usagi-avionica/usagi-core/usagi-core.kicad_pcb

## KiCad design usagi-core.kicad_pcb (2026-11-13)

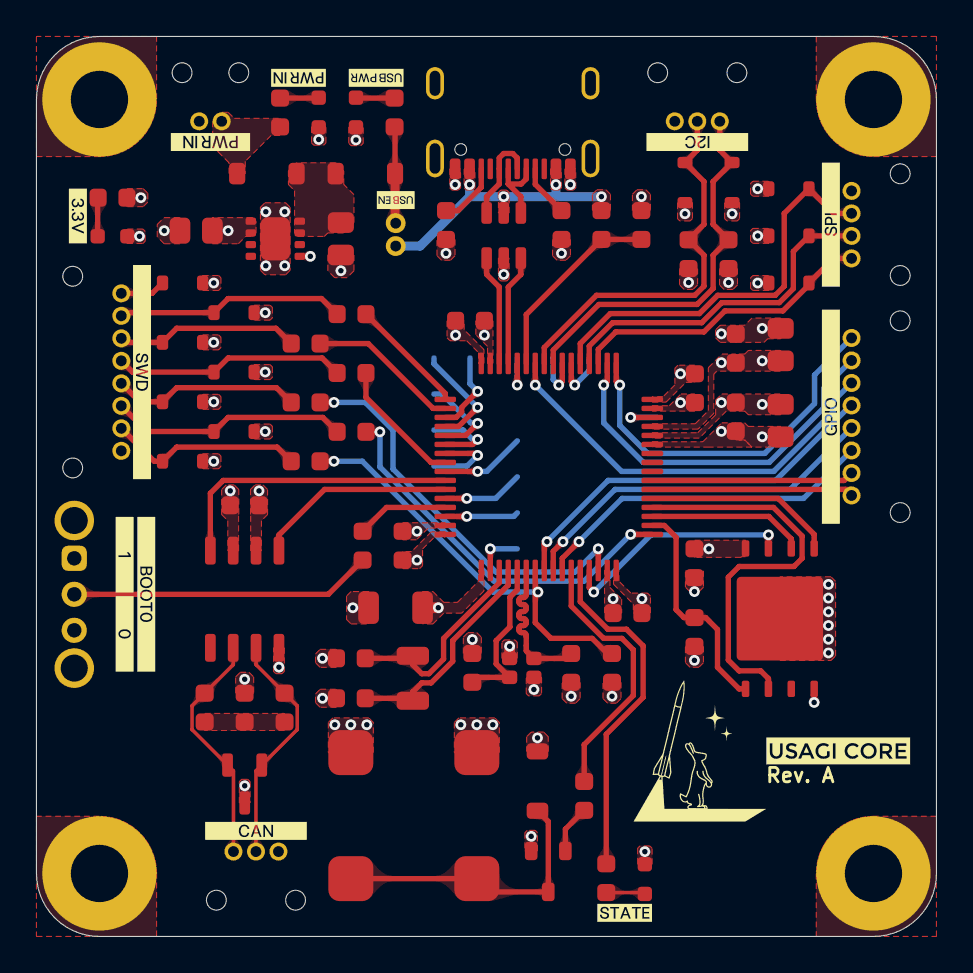
[picture p1: board usagi-core.kicad_pcb from above]

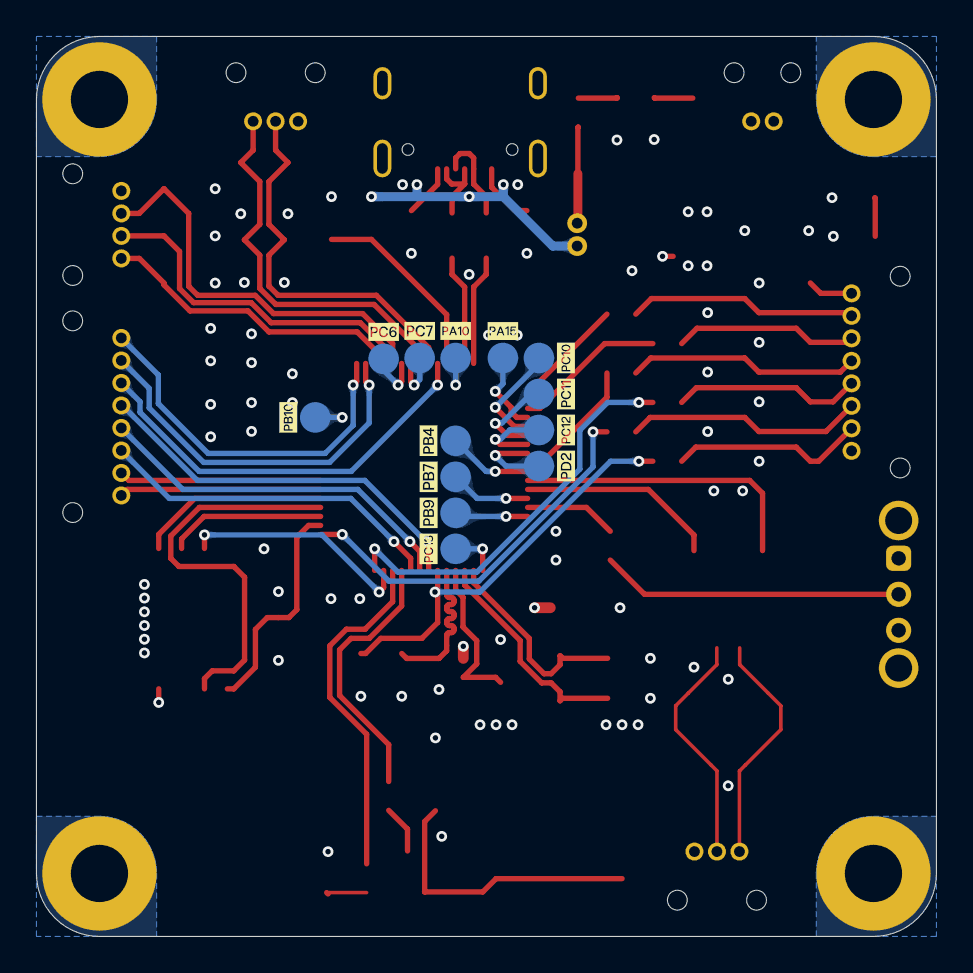
[picture p2: board usagi-core.kicad_pcb from below]

Board: 4 copper layers, 50.0 x 50.0 mm, 123 parts (26 on the bottom side), 75 nets.

Parts:
BZ1: CMT-8540S-SMT-TR
C1, C2, C3, C4, C8, C10, C15, C17: 100nF; C_0603_Density_Nominal
C5: 4.7μF; C_1206_Density_Nominal
C6: 10nF; C_0603_Density_Nominal
C7, C9, C18: 1μF; C_0805_Density_Nominal
C11, C12: 6.8pF; C_0603_Density_Nominal
C13, C14: 5.1pF; C_0603_Density_Nominal
C16: 4.7nF; C_0603_Density_Nominal
C19: 10μF; C_0805_Density_Nominal
D1, D15, D18, D19: Green; SML-D12P8WT86C
D2, D3, D4, D5, D6, D7, D8, D9, D10, D11, D12, D13: SZESD7351HT1G
D14, D16, D17: STPS140ZY
J1: USB4105-GF-A-120
J2, J7: 2200980871
J3, J4: 2200980371
J5: 2200980471
J6: 2200980271
J8, J9, J10, J11, J12, J13, J14, J15, J16, J17, J18, J19, J20: SolderPad
J21: M50-3530242
MH1, MH2, MH3, MH4: M3
Q1: SMMBT2222ALT1G
R1, R2: 1.8kΩ; R_0603_Density_Nominal
R3, R8: 10kΩ; R_0603_Density_Nominal
R4, R5: 5.1kΩ; R_0603_Density_Nominal
R6: 82kΩ; R_0603_Density_Nominal
R7: 33kΩ; R_0603_Density_Nominal
R9, R10: 60.4Ω; R_0603_Density_Nominal
R11, R21: 100Ω; R_0603_Density_Nominal
R12, R13, R14, R15, R16, R17: 49.9Ω; R_0603_Density_Nominal
R18, R19, R20: 220Ω; R_0603_Density_Nominal
SW1: OS102011MA1QN1
U1: STM32G474RET3
U2: USBLC6-2SC6
U3: S25FL256LAGNFM010
U4: SN65HVD231QDRG4Q1
U5: ESD2CAN24DBZRQ1
U6: NCV8187AMLE330TCG
Y1: 24MHz; CS10820-24M
Y2: 32.768kHz; MU00525-32.768K
kibuzzard-6AF2C97C: G***; kibuzzard-6AF2C97C
kibuzzard-6AF2CA52: G***; kibuzzard-6AF2CA52
kibuzzard-6AF2CCF0: G***; kibuzzard-6AF2CCF0
kibuzzard-6AF3A4A3: G***; kibuzzard-6AF3A4A3
kibuzzard-6AF3A46B: G***; kibuzzard-6AF3A46B
kibuzzard-6AF3A47A: G***; kibuzzard-6AF3A47A
kibuzzard-6AF3A482: G***; kibuzzard-6AF3A482
kibuzzard-6AF3A495: G***; kibuzzard-6AF3A495
kibuzzard-6AF5A14A: G***; kibuzzard-6AF5A14A
kibuzzard-6AF5D7C2: G***; kibuzzard-6AF5D7C2
kibuzzard-6AF578D1: G***; kibuzzard-6AF578D1
kibuzzard-6AF578DA: G***; kibuzzard-6AF578DA
kibuzzard-6AF578E0: G***; kibuzzard-6AF578E0
kibuzzard-6AF578EA: G***; kibuzzard-6AF578EA
kibuzzard-6AF1947B: G***; kibuzzard-6AF1947B
kibuzzard-6AF1962F: G***; kibuzzard-6AF1962F
kibuzzard-6AF4418B: G***; kibuzzard-6AF4418B
kibuzzard-6AF5783D: G***; kibuzzard-6AF5783D
kibuzzard-6AF5791D: G***; kibuzzard-6AF5791D
kibuzzard-6AF5792A: G***; kibuzzard-6AF5792A
kibuzzard-6AF5796A: G***; kibuzzard-6AF5796A
kibuzzard-6AF19634: G***; kibuzzard-6AF19634
kibuzzard-6AF44698: G***; kibuzzard-6AF44698
kibuzzard-6AF57785: G***; kibuzzard-6AF57785
kibuzzard-6AF57819: G***; kibuzzard-6AF57819
kibuzzard-6AF57844: G***; kibuzzard-6AF57844
kibuzzard-6AF57915: G***; kibuzzard-6AF57915
kibuzzard-6AF57924: G***; kibuzzard-6AF57924

Connections:
+3.3V: BZ1.1 (+), C1.1, C2.1, C3.1, C4.1, C5.1, C6.1, C7.1, C8.1, C9.1, C15.1, C17.1, C19.1, D2.1, D14.1, J2.1, R1.1, R2.1, R8.1, R21.1, SW1.1, U1.1 (VBAT), U1.16 (VDD), U1.28 (VREF+), U1.29 (VDDA), U1.32 (VDD), U1.48 (VDD), U1.64 (VDD), U3.8 (VCC), U4.3 (VCC), U6.1 (OUT), U6.2 (SNS)
/CAN_N: J3.1, R10.2, U4.6 (CANL), U5.2 (I/O2)
/CAN_P: J3.2, R9.1, U4.7 (CANH), U5.1 (I/O1)
/MCU_BOOT0: R3.1, U1.61 (BOOT0)
/MCU_HSE_IN: C11.1, U1.5 (OSC_IN), Y1.1
/MCU_HSE_OUT: C12.1, U1.6 (OSC_OUT), Y1.3
/MCU_LED: R11.1, U1.12 (PA0)
/MCU_LSE_IN: C13.1, U1.3 (OSC32_IN), Y2.1
/MCU_LSE_OUT: C14.1, U1.4 (OSC32_OUT), Y2.2
/USB_CONN_CC1: J1.A5 (CC1), R5.1
/USB_CONN_CC2: J1.B5 (CC2), R4.1
/USB_CONN_D+: J1.A6 (DP1), J1.B6 (DP2), U2.6 (I/O1)
/USB_CONN_D-: J1.A7 (DN1), J1.B7 (DN2), U2.4 (I/O2)
GND: C1.2, C2.2, C3.2, C4.2, C5.2, C6.2, C7.2, C8.2, C9.2, C10.2, C11.2, C12.2, C13.2, C14.2, C15.2, C16.2, C17.2, C18.2, C19.2, D1.1, D2.2, D3.2, D4.2, D5.2, D6.2, D7.2, D8.2, D9.2, D10.2, D11.2, D12.2, D13.2, D15.1, D18.1, D19.1, J1.A1 (GND), J1.A12 (GND), J1.B1 (GND), J1.B12 (GND), J1.SH, J2.8, J3.3, J4.3, J5.4, J6.2, Q1.2 (E), R4.2, R5.2, R7.2, SW1.3, U1.15 (VSS), U1.27 (VSSA), U1.31 (VSS), U1.47 (VSS), U1.63 (VSS), U2.2 (GND), U3.4 (VSS), U3.9 (EP), U4.2 (GND), U4.8 (RS), U5.3 (GND), U6.5 (GND), U6.9 (GND), Y1.2 (GND), Y1.4 (GND)
MCU_BUZZER: R18.1, U1.11 (PC3)
MCU_CAN2_RX: U1.58 (FDCAN2_RX), U4.4 (R)
MCU_CAN2_TX: U1.59 (FDCAN2_TX), U4.1 (D)
MCU_I2C3_SCL: D10.1, J4.1, R1.2, U1.40 (I2C3_SCL)
MCU_I2C3_SDA: D9.1, J4.2, R2.2, U1.41 (I2C3_SDA)
MCU_MEM_CS: R8.2, U1.18 (PA4), U3.1 (CS)
MCU_MEM_NRST: U1.13 (PA1), U3.7 (~RESET)
MCU_NRST: C10.1, R15.1, U1.7 (NRST)
MCU_SPI1_MISO: U1.20 (SPI1_MISO), U3.2 (SO)
MCU_SPI1_MOSI: U1.21 (SPI1_MOSI), U3.5 (SI)
MCU_SPI1_SCK: U1.19 (SPI1_SCK), U3.6 (SCK)
MCU_SPI2_MISO: D12.1, J5.2, U1.36 (SPI2_MISO)
MCU_SPI2_MOSI: D11.1, J5.3, U1.37 (SPI2_MOSI)
MCU_SPI2_SCK: D13.1, J5.1, U1.35 (SPI2_SCK)
MCU_SWCLK: R13.1, U1.50 (SWCLK-JTCK)
MCU_SWDIO: R12.1, U1.49 (SWDIO-JTMS)
MCU_SWO: R14.1, U1.56 (JTDO-TRACESWO)
MCU_USART2_RX: R16.1, U1.17 (USART2_RX)
MCU_USART2_TX: R17.1, U1.14 (USART2_TX)
MCU_USB_D+: U1.46 (USB_DP), U2.1 (I/O1)
MCU_USB_D-: U1.45 (USB_DM), U2.3 (I/O2)
MCU_USB_VUSB: R6.2, R7.1, U1.43 (PA9)
unnamed: BZ1.2 (-), D14.2, Q1.3 (C)
unnamed: C16.1, R9.2, R10.1
unnamed: D1.2, R11.2
unnamed: D3.1, J2.2, R12.2
unnamed: D4.1, J2.3, R13.2
unnamed: D5.1, J2.4, R14.2
unnamed: D6.1, J2.5, R17.2
unnamed: D7.1, J2.6, R16.2
unnamed: D8.1, J2.7, R15.2
unnamed: D15.2, R19.2
unnamed: D16.2, J6.1, R20.1
unnamed: D17.2, J21.2, R19.1
unnamed: D18.2, R20.2
unnamed: D19.2, R21.2
unnamed: Q1.1 (B), R18.2
unnamed: R3.2, SW1.2
unnamed: C18.1, D16.1, D17.1, U6.7 (EN), U6.8 (IN)
PA8: J7.6, U1.42 (PA8)
PA10: J8.1 (1_1), U1.44 (PA10)
PA15: J20.1 (1_1), U1.51 (PA15)
PB4: J15.1 (1_1), U1.57 (PB4)
PB7: J14.1 (1_1), U1.60 (PB7)
PB9: J13.1 (1_1), U1.62 (PB9)
PB10: J11.1 (1_1), U1.30 (PB10)
PB11: J7.8, U1.33 (PB11)
PB12: J7.7, U1.34 (PB12)
PC0: J7.5, U1.8 (PC0)
PC1: J7.4, U1.9 (PC1)
PC2: J7.3, U1.10 (PC2)
PC4: J7.1, U1.22 (PC4)
PC5: J7.2, U1.23 (PC5)
PC6: J10.1 (1_1), U1.38 (PC6)
PC7: J9.1 (1_1), U1.39 (PC7)
PC10: J19.1 (1_1), U1.52 (PC10)
PC11: J18.1 (1_1), U1.53 (PC11)
PC12: J17.1 (1_1), U1.54 (PC12)
PC13: J12.1 (1_1), U1.2 (PC13)
PD2: J16.1 (1_1), U1.55 (PD2)
VUSB: J1.A4 (VBUS), J1.A9 (VBUS), J1.B4 (VBUS), J1.B9 (VBUS), J21.1, R6.1, U2.5 (VBUS)
