usagi-avionica/usagi-core/usagi-core.ioc

Mcu.UserName=STM32G474RETx
PA0.GPIO_Label=MCU_LED
PA0.Signal=GPIO_Output
PA1.GPIO_Label=MCU_MEM_NRST
PA1.Signal=GPIO_Output
PA11.Signal=USB_DM
PA12.Signal=USB_DP
PA13.Signal=SYS_JTMS-SWDIO
PA14.Signal=SYS_JTCK-SWCLK
PA2.Signal=USART2_TX
PA3.Signal=USART2_RX
PA4.GPIO_Label=MCU_MEM_CS
PA4.Signal=GPIO_Output
PA5.Signal=SPI1_SCK
PA6.Signal=SPI1_MISO
PA7.Signal=SPI1_MOSI
PA9.GPIO_Label=USB_VBUS
PA9.Signal=GPIO_Input
PB13.Signal=SPI2_SCK
PB14.Signal=SPI2_MISO
PB15.Signal=SPI2_MOSI
PB3.Signal=SYS_JTDO-SWO
PB5.Signal=FDCAN2_RX
PB6.Signal=FDCAN2_TX
PC14-OSC32_IN.Signal=RCC_OSC32_IN
PC15-OSC32_OUT.Signal=RCC_OSC32_OUT
PC3.Signal=S_TIM1_CH4
PC8.Signal=I2C3_SCL
PC9.Signal=I2C3_SDA
PF0-OSC_IN.Signal=RCC_OSC_IN
PF1-OSC_OUT.Signal=RCC_OSC_OUT
