usagi-avionica/usagi-core/(commit log)

2026-11-12 Initial commit.
    [usagi-core.kicad_pcb, usagi-core.kicad_sch]
2026-11-12 Add missing project text variables.
    [usagi-core.kicad_pcb, usagi-core.kicad_sch]
2026-11-12 Enable font embedding.
    [usagi-core.kicad_pcb, usagi-core.kicad_sch]
2026-11-12 Pin workflow to Ubuntu 24.04
2026-11-12 Change power "pin not driven" severity from error to warning.
2026-11-12 Fix PCB colors in preview images, change release structure to be flatter.
2026-11-12 Fix 3.3V plane pour priority.
    [usagi-core.kicad_pcb]
2026-11-13 Add dimensions on fabrication layer.
    [usagi-core.kicad_pcb]
2026-11-13 Change release names to include "Revision" for better readability, increase image size for PCB
2026-11-13 Update library symbols to fix PN with whitespaces, fix diode identifier.
    [usagi-core.kicad_pcb, usagi-core.kicad_sch]
2026-11-13 Remove bottom side GPIO pads from BOM and position files
    [usagi-core.kicad_pcb, usagi-core.kicad_sch]
