usagi-avionica/usagi-core/(notices)

Notices in the files:
parts and their libraries:
LICENSE: CERN-OHL-S
